ruralguru/all_lit_up_coaster/README.md

# all_lit_up_coaster
LED coaster design,
