ruralguru/all_lit_up_coaster/Rev1p1/README.md

# all_lit_up_coaster
LED coaster design.
Created in conjunction with Mad Physist.
Alternating LED design using 555 timer, powered by 4x AAA, Aluminum Can Trigger.
Some moderate soldering required.
