ruralguru/all_lit_up_coaster/Rev1p1/All_Lit_Up_Schematic.pdf

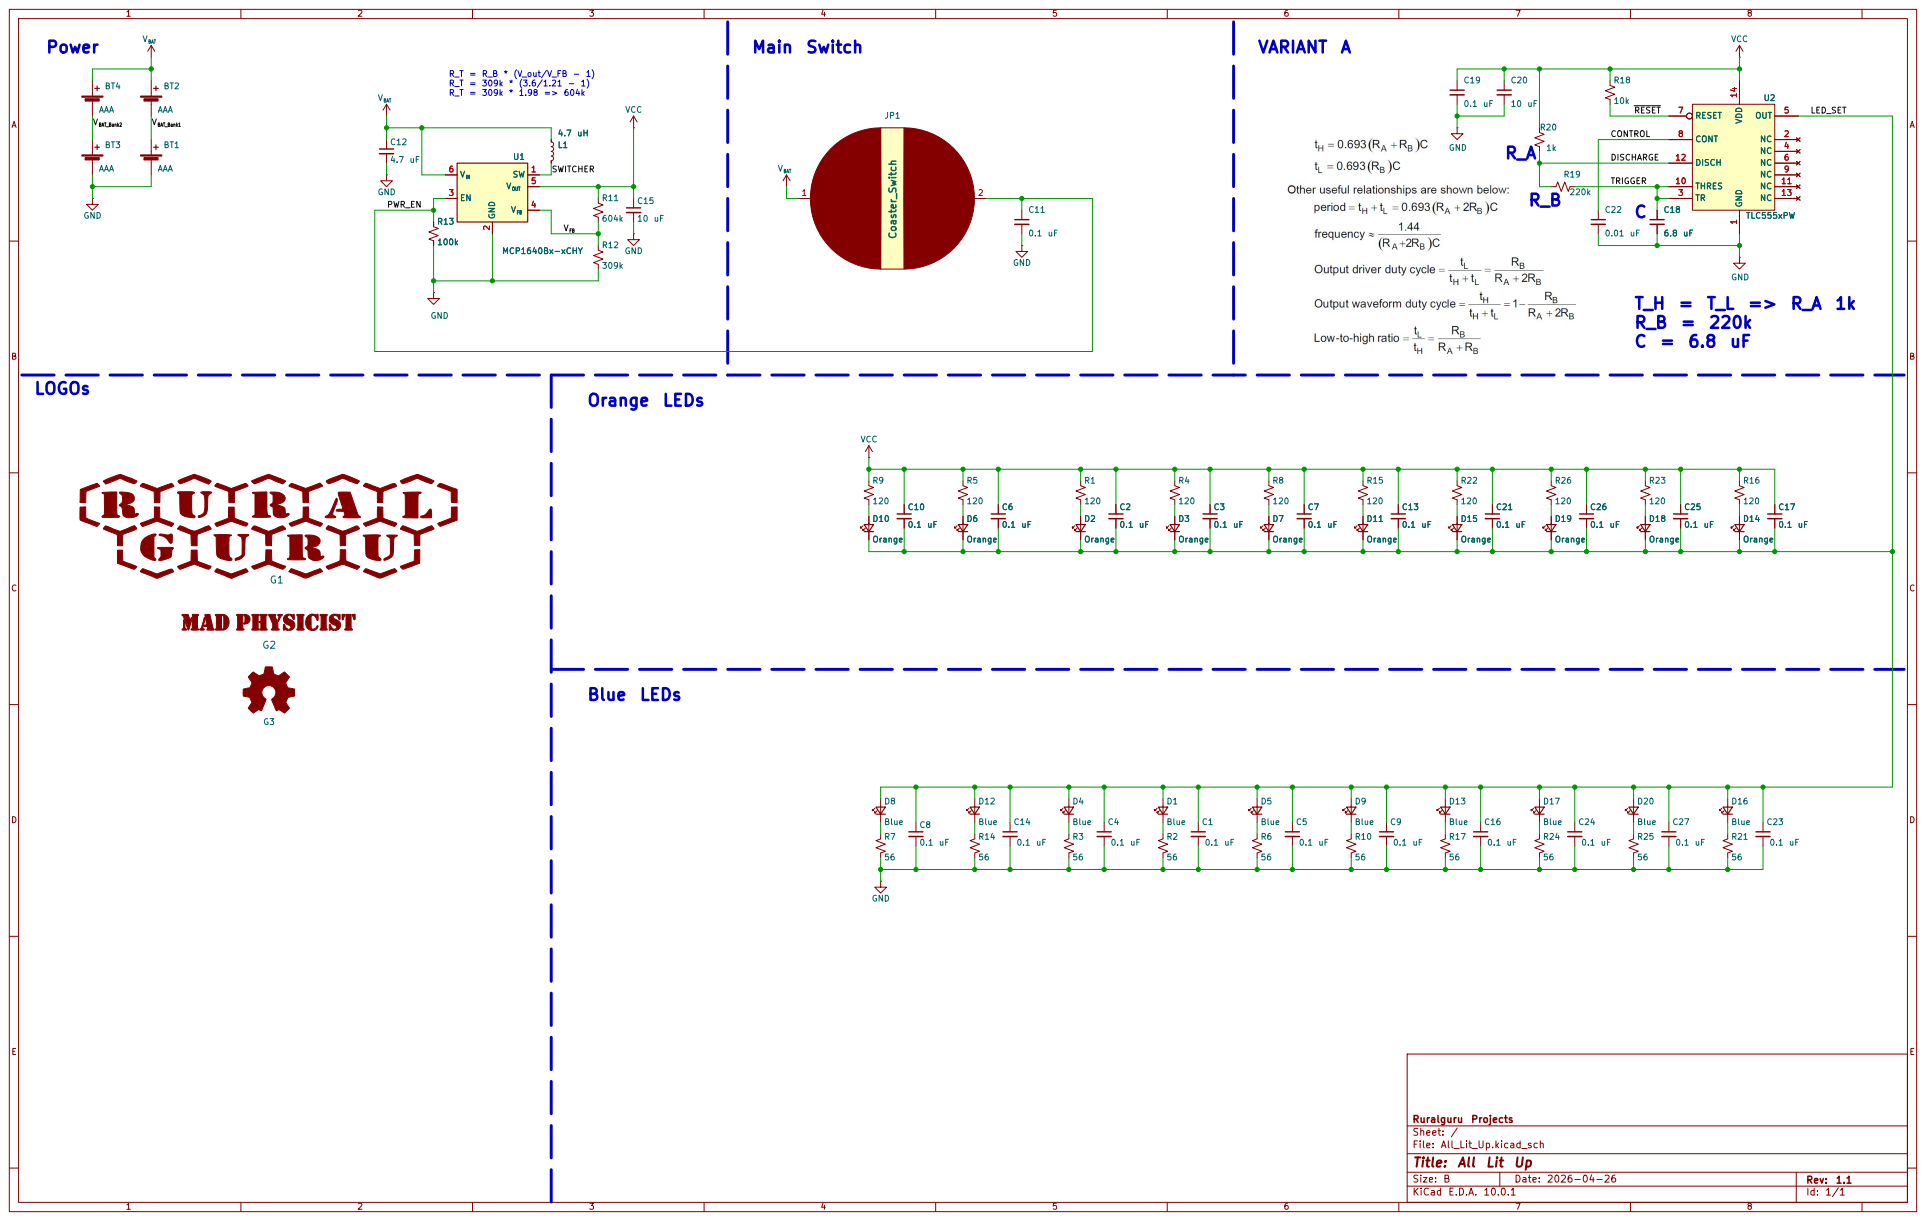
[picture p1: page 1]

Ruralguru Projects
Sheet: /
File: All_Lit_Up.kicad_sch
Title: All Lit Up

Size: B | Rev: 1.1
KiCad E.D.A. 10.0.1 | Id: 1/1
