ruralguru/all_lit_up_coaster/Rev1p1/All_Lit_Up.kicad_pcb

## KiCad design Rev1p1/All_Lit_Up.kicad_pcb (2026-06-21)

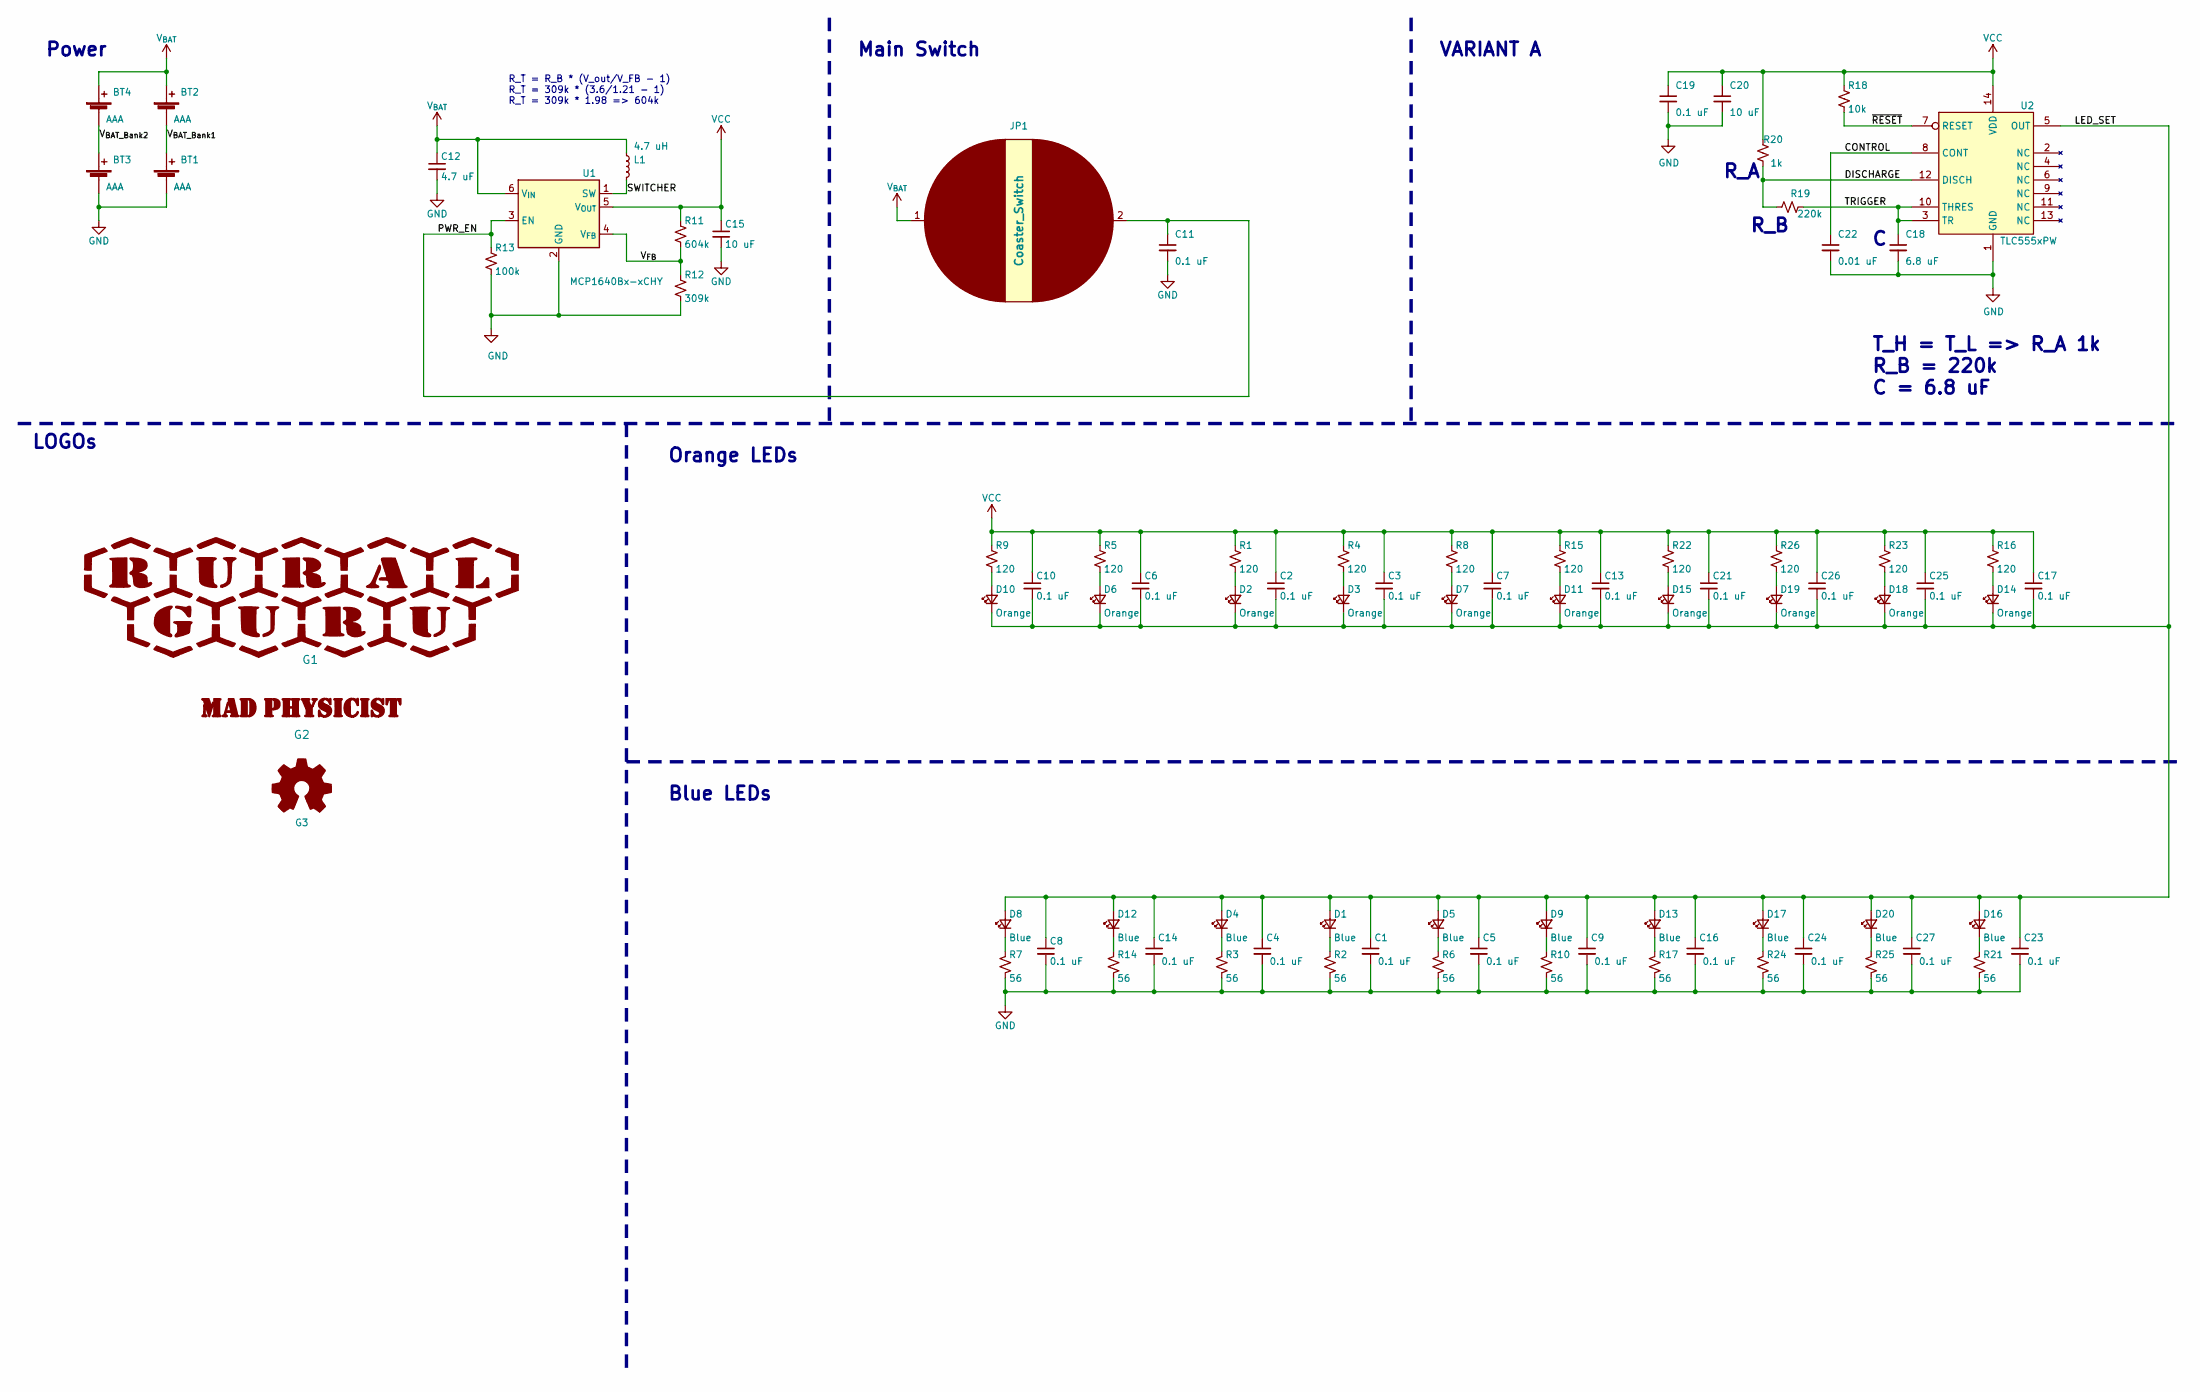
[picture p2: schematic All_Lit_Up.kicad_sch, All Lit Up]

Parts:
BT1, BT2, BT3, BT4: AAA; ERW_Battery_Keystone_55(x2)_AAAA; MPN 55 (x2)
C1, C2, C3, C4, C5, C6, C7, C8, C9, C10, C11, C13, C14, C16, C17, C19, C21, C23, C24, C25, C26, C27: 0.1 uF; C_0603_1608Metric; MPN CL10B104KA8NNNC
C12: 4.7 uF; C_0603_1608Metric; MPN GRM188Z71A475ME15D
C15, C20: 10 uF; C_0603_1608Metric; MPN GRM188Z71A106KA73D
C18: 6.8 uF; C_0603_1608Metric; MPN C1608X7S0J685K080AC
C22: 0.01 uF; C_0603_1608Metric; MPN C1608C0G1E103J080AA
D1, D4, D5, D8, D9, D12, D13, D16, D17, D20: Blue; LED_0603_1608Metric; MPN E1221NB--05D000814U1930
D2, D3, D6, D7, D10, D11, D14, D15, D18, D19: Orange; LED_0603_1608Metric; MPN B1911UD--20D001014U1930
G1: LOGO; RuralguruProjects_HEX_2000
G2: Phillip_LOGO; PJ_LOGO_1p5l
G3: Logo_Open_Hardware_Small; OSHW-Symbol_6.7x6mm_SilkScreen
JP1: Coaster_Switch; Coaster_SW
L1: 4.7 uH; L_VLCF4020T; MPN VLCF4020T-4R7N1R2
R1, R4, R5, R8, R9, R15, R16, R22, R23, R26: 120; R_0603_1608Metric; MPN RT0603FRE07120RL
R2, R3, R6, R7, R10, R14, R17, R21, R24, R25: 56; R_0603_1608Metric; MPN RT0603FRE0756RL
R11: 604k; R_0603_1608Metric; MPN RMCF0603FT604K
R12: 309k; R_0603_1608Metric; MPN RMCF0603FT309K
R13: 100k; R_0603_1608Metric; MPN ERJ-3EKF1003V
R18: 10k; R_0603_1608Metric; MPN CRGCQ0603F10K
R19: 220k; R_0603_1608Metric; MPN RMCF0603FT220K
R20: 1k; R_0603_1608Metric; MPN RT0603FRE131KL
U1: MCP1640Bx-xCHY; SOT-23-6; MPN MCP1640BT-I/CHY
U2: TLC555xPW; TSSOP-14_4.4x5mm_P0.65mm; MPN TLC555CPWR

Connections:
/CONTROL: C22.1, U2.8 (CONT)
/DISCHARGE: R19.2, R20.1, U2.12 (DISCH)
/LED_SET: C1.1, C2.2, C3.2, C4.1, C5.1, C6.2, C7.2, C8.1, C9.1, C10.2, C13.2, C14.1, C16.1, C17.2, C21.2, C23.1, C24.1, C25.2, C26.2, C27.1, D1.2 (A), D2.1 (K), D3.1 (K), D4.2 (A), D5.2 (A), D6.1 (K), D7.1 (K), D8.2 (A), D9.2 (A), D10.1 (K), D11.1 (K), D12.2 (A), D13.2 (A), D14.1 (K), D15.1 (K), D16.2 (A), D17.2 (A), D18.1 (K), D19.1 (K), D20.2 (A), U2.5 (OUT)
/PWR_EN: C11.1, JP1.2 (B), R13.1, U1.3 (EN)
/SWITCHER: L1.2, U1.1 (SW)
/TRIGGER: C18.1, R19.1, U2.3 (TR), U2.10 (THRES)
/V_{BAT_Bank1}: BT1.1 (+), BT2.2 (-)
/V_{BAT_Bank2}: BT3.1 (+), BT4.2 (-)
/V_{FB}: R11.2, R12.1, U1.4 (V_{FB})
/~RESET: R18.2, U2.7 (RESET)
GND: BT1.2 (-), BT3.2 (-), C1.2, C4.2, C5.2, C8.2, C9.2, C11.2, C12.2, C14.2, C15.2, C16.2, C18.2, C19.2, C20.2, C22.2, C23.2, C24.2, C27.2, R2.2, R3.2, R6.2, R7.2, R10.2, R12.2, R13.2, R14.2, R17.2, R21.2, R24.2, R25.2, U1.2 (GND), U2.1 (GND)
unnamed: D1.1 (K), R2.1
unnamed: D2.2 (A), R1.2
unnamed: D3.2 (A), R4.2
unnamed: D4.1 (K), R3.1
unnamed: D5.1 (K), R6.1
unnamed: D6.2 (A), R5.2
unnamed: D7.2 (A), R8.2
unnamed: D8.1 (K), R7.1
unnamed: D9.1 (K), R10.1
unnamed: D10.2 (A), R9.2
unnamed: D11.2 (A), R15.2
unnamed: D12.1 (K), R14.1
unnamed: D13.1 (K), R17.1
unnamed: D14.2 (A), R16.2
unnamed: D15.2 (A), R22.2
unnamed: D16.1 (K), R21.1
unnamed: D17.1 (K), R24.1
unnamed: D18.2 (A), R23.2
unnamed: D19.2 (A), R26.2
unnamed: D20.1 (K), R25.1
VCC: C2.1, C3.1, C6.1, C7.1, C10.1, C13.1, C15.1, C17.1, C19.1, C20.1, C21.1, C25.1, C26.1, R1.1, R4.1, R5.1, R8.1, R9.1, R11.1, R15.1, R16.1, R18.1, R20.2, R22.1, R23.1, R26.1, U1.5 (V_{OUT}), U2.14 (VDD)
V_{BAT}: BT2.1 (+), BT4.1 (+), C12.1, JP1.1 (A), L1.1, U1.6 (V_{IN})

Notes on the sheet:
VARIANT A
LOGOs
Blue LEDs
Main Switch
T_H = T_L => R_A 1k R_B = 220k C = 6.8 uF
R_A
R_B
Power
R_T = R_B * (V_out/V_FB - 1) R_T = 309k * (3.6/1.21 - 1) R_T = 309k * 1.98 => 604k
Orange LEDs

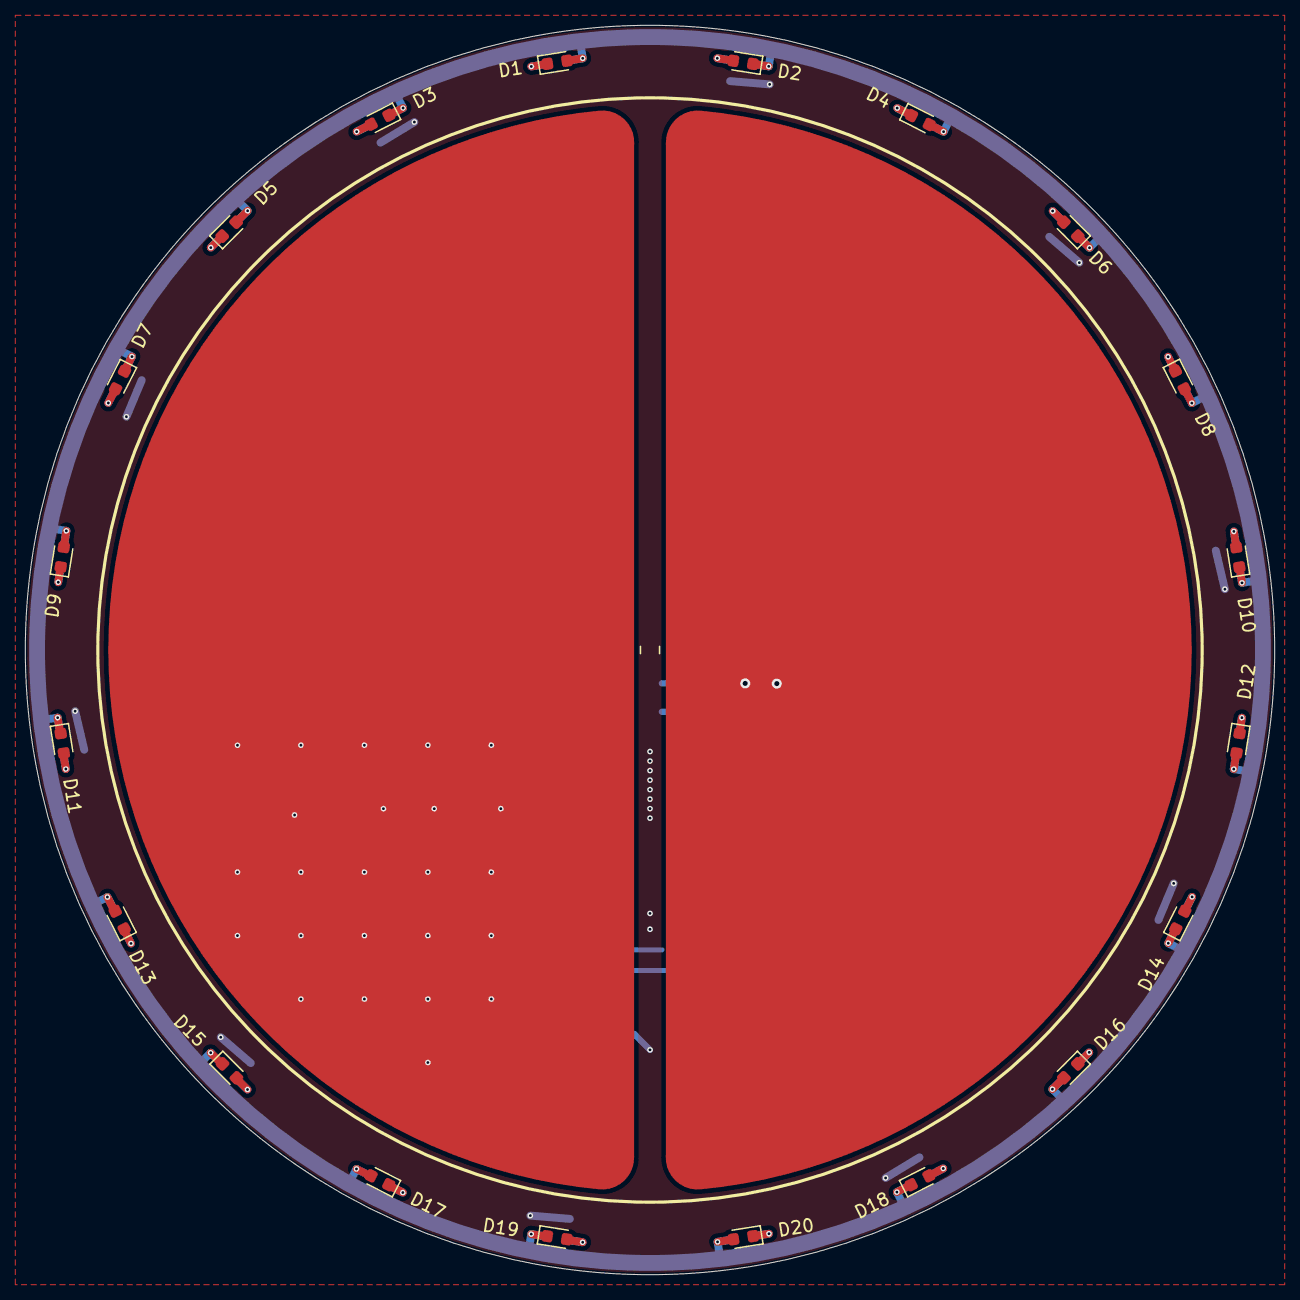
[picture p3: board All_Lit_Up.kicad_pcb from above]

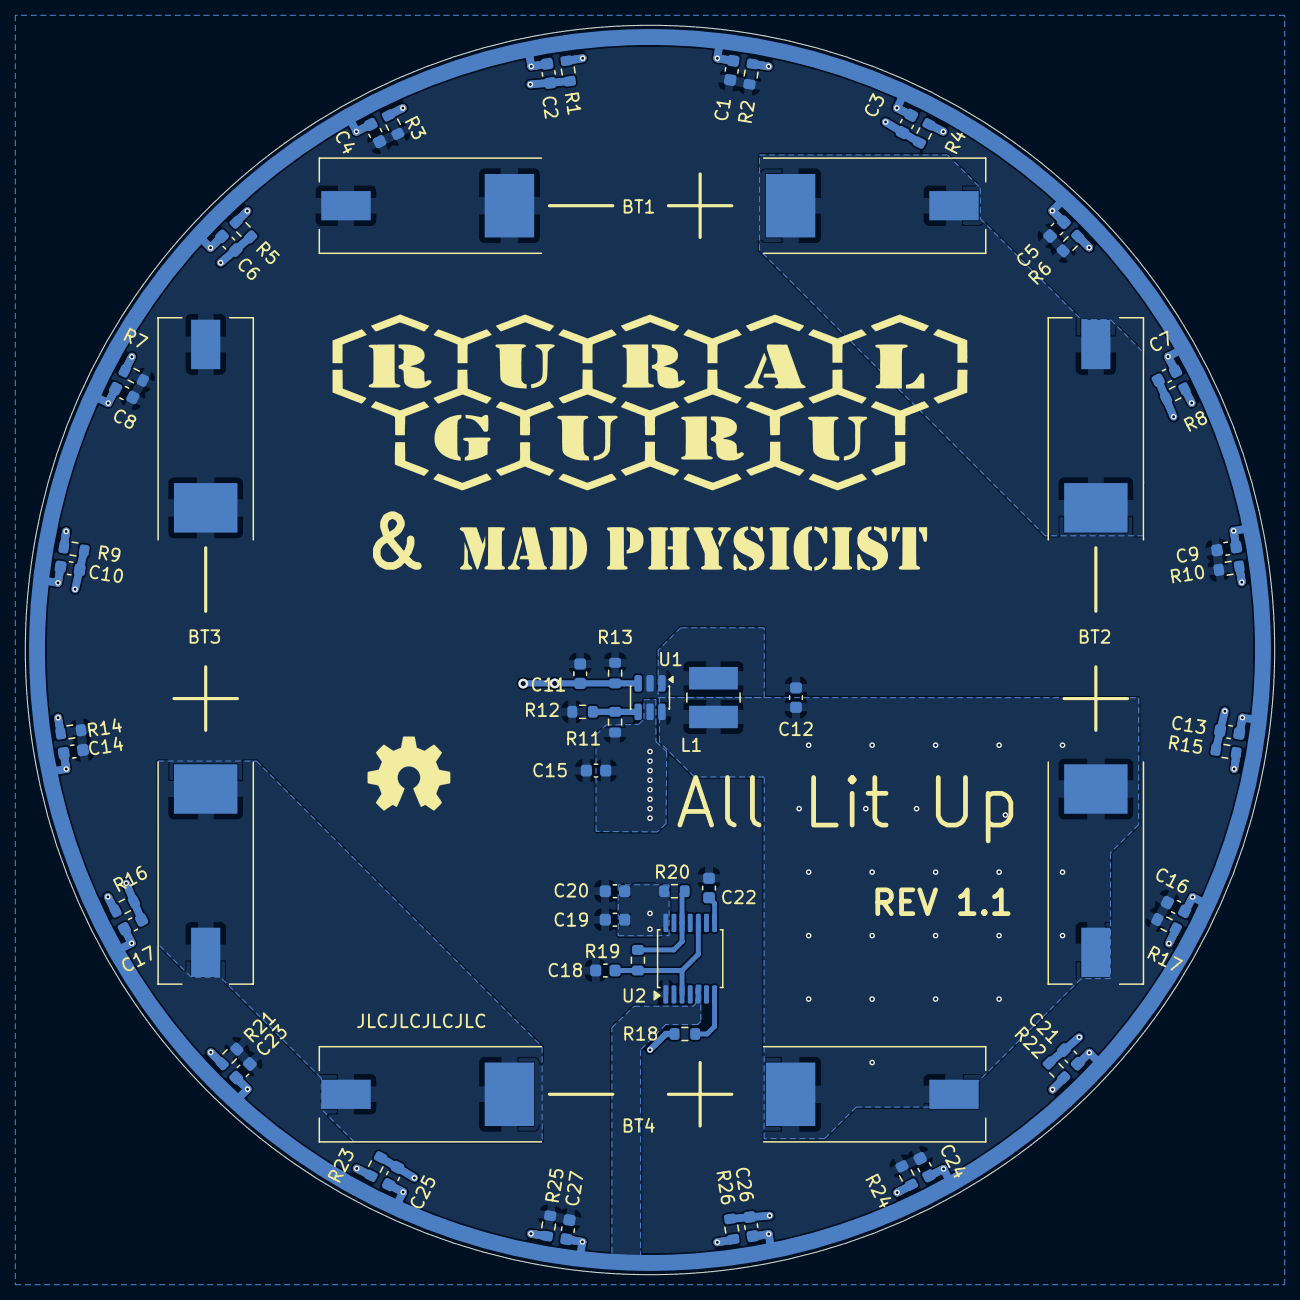
[picture p4: board All_Lit_Up.kicad_pcb from below]

Board: 2 copper layers, 100.0 x 100.0 mm, 84 parts (63 on the bottom side), 33 nets.
