ruralguru/all_lit_up_coaster/Rev1p1/Assembly/LED Details.pdf

Manufacturer Part Number | Color | Resistor
| | (Ω) | Current
| | | (mA) | Luminous
| | | | (mcd) | Brightness
(L*)
B1911USD-20D000114U1930 RED | 82 | 19.5 | 45 | 42
B1911UD--20D001014U1930 | ORANGE | 120 | 13.3 | 38 | 42
B1931UY--20D000114U1930 | AMBER | 100 | 16 | 35 | 42
B1931UYG-20D000314U1930 GREEN-YELLOW | 82 | 18.3 | 37 | 42
B1911NG--20D000214U1930 GREEN | 82 | 3.6 | 42 | 42
E1221NB--05D000814U1930 | BLUE | 56 | 14.3 | 46 | 42
B1931TW--20P000314U1930 WHITE | 82 | 4.9 | 36 | 42

# Blue LED, E1221NB—05D000814U1930:

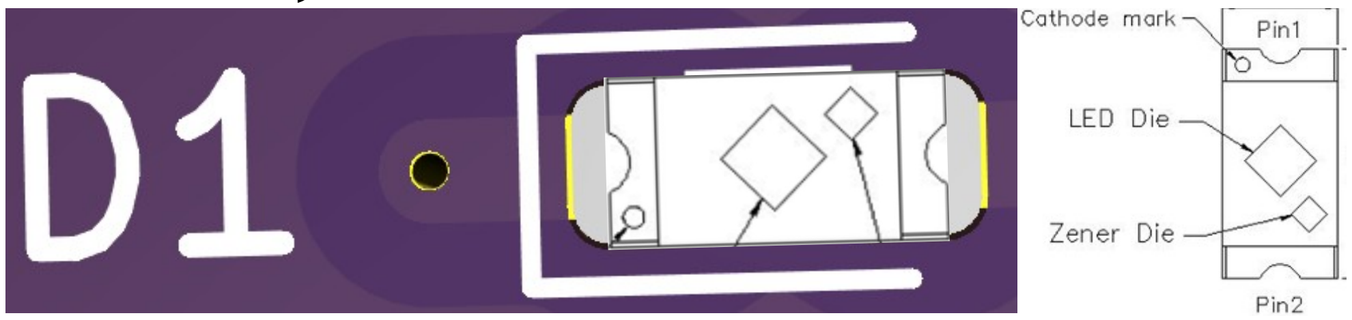
[picture p5: figure]

# Orange LED, B1911UD—20D001014U1930:

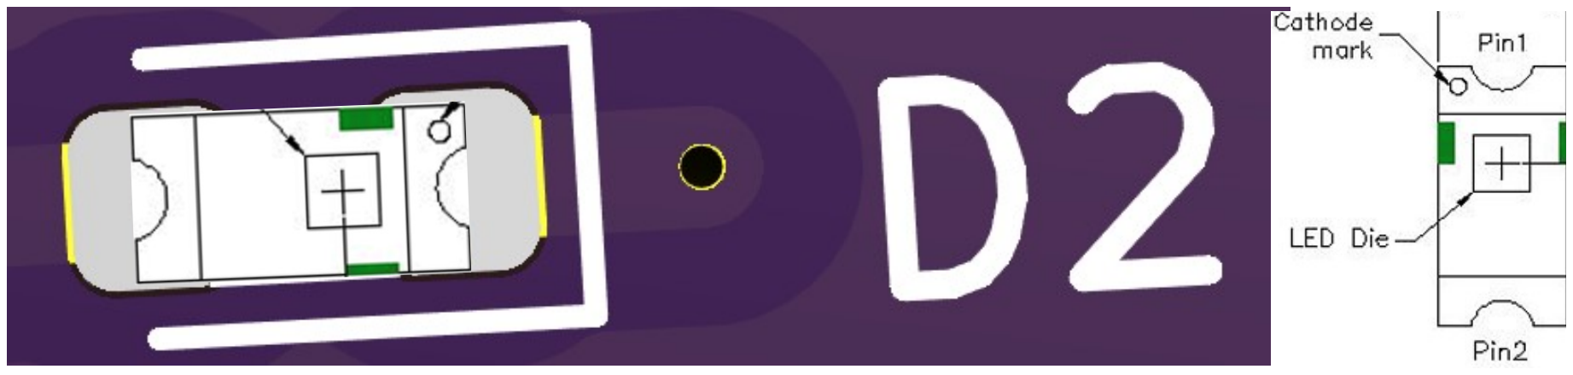
[picture p6: figure]
