ruralguru/all_lit_up_coaster/(commit log)

2022-01-22 initial commit with rev 1.0 design
    rev 1.0 commit.
    [Coaster.kicad_pcb, Coaster.kicad_sch]
2026-04-27 Rev B Commit
    [All_Lit_Up-B_Cu.gbl, All_Lit_Up-B_Mask.gbs, All_Lit_Up-B_Paste.gbp, All_Lit_Up-B_Silkscreen.gbo, All_Lit_Up-Edge_Cuts.gm1, All_Lit_Up-F_Cu.gtl, All_Lit_Up-F_Mask.gts, All_Lit_Up-F_Paste.gtp]
2026-04-27 changed to 1.1 rev
    [All_Lit_Up-B_Cu.gbl, All_Lit_Up-B_Mask.gbs, All_Lit_Up-B_Paste.gbp, All_Lit_Up-B_Silkscreen.gbo, All_Lit_Up-Edge_Cuts.gm1, All_Lit_Up-F_Cu.gtl, All_Lit_Up-F_Mask.gts, All_Lit_Up-F_Paste.gtp]
2026-04-27 Improved 1p1 Design
    Cleaned up design, removed DFN for SOIC. added BOM, Schematic, & Step Files. reduced size to 100mm x 100mm. improved traces & Vias.
    [All_Lit_Up-B_Cu.gbl, All_Lit_Up-B_Mask.gbs, All_Lit_Up-B_Paste.gbp, All_Lit_Up-B_Silkscreen.gbo, All_Lit_Up-Edge_Cuts.gm1, All_Lit_Up-F_Cu.gtl, All_Lit_Up-F_Mask.gts, All_Lit_Up-F_Paste.gtp]
2026-06-21 Update to working model
    Change LEDs to used Value, Correct to 1k, change resistor values to used. Add LED choice and orientation with silk. correct silk for 1 LED Cap combo. update gbrs. update output documents. Added iBOM
    [All_Lit_Up-B_Cu.gbl, All_Lit_Up-B_Mask.gbs, All_Lit_Up-B_Paste.gbp, All_Lit_Up-B_Silkscreen.gbo, All_Lit_Up-Edge_Cuts.gm1, All_Lit_Up-F_Cu.gtl, All_Lit_Up-F_Mask.gts, All_Lit_Up-F_Paste.gtp]
